ricardoquesada/unipad/firmware/README.md

# Unipad™ Firmware

This directory contains the board-specific **Raspberry Pi Pico 2 W (`RP2350` + `CYW43439`)** firmware, cycle-exact Programmable I/O (`PIO`) hardware state machines, and [Bluepad32](https://github.com/ricardoquesada/bluepad32) platform integration for **Unipad** retro computer adapters.

## Directory Layout

```text
firmware/
├── external/               # Third-party / upstream git submodules (isolated from 1st-party code)
│   └── bluepad32/          # Bluepad32 Bluetooth Classic + BLE HID stack (git submodule)
├── common/                 # Shared RP2350 drivers & hardware contracts across Unipad boards
│   ├── CMakeLists.txt      # unipad_common static library target
│   ├── include/
│   │   └── unipad_board_id.h       # 3-bit BOARD_ID[2:0] = {GP28, GP27, GP26} contract & registry
│   └── src/
│       └── unipad_board_id.c       # Boot-time pull-up sampling, majority vote & post-boot pad isolation
└── unipad_c64/             # Unipad C64 (Rev. A) target — defaults to PICO_BOARD=pico2_w
    ├── CMakeLists.txt      # Pico SDK 2.x + Bluepad32 + hardware_pio + unipad_common build definition
    ├── pico_sdk_import.cmake
    ├── include/
    │   ├── unipad_c64_pins.h       # Exact RP2350 pinout matching hardware/unipad_c64/pico2w.kicad_sch
    │   ├── unipad_c64_gpio.h       # Atomic 5-bit SIO ports, LEDs, autofire & pushbutton debouncer
    │   ├── unipad_c64_pio.h        # PIO SID 1351 mouse, 1311/1312 paddles, POT buttons & Rumble/Sync
    │   ├── unipad_c64_platform.h   # Bluepad32 custom uni_platform & runtime mode/seat control
    │   └── unipad_c64_console.h    # Non-blocking USB CDC & UART0 interactive CLI
    ├── pio/
    │   └── c64_sid_pot.pio         # RP2350 PIO state machines (c64_sid_pot & c64_sid_sync_measure)
    └── src/
        ├── btstack_config.h        # Dual-mode Classic BR/EDR + BLE + Flash TLV configuration
        ├── sdkconfig.h             # Bluepad32 PICO_W + custom platform configuration
        ├── main.c                  # RP2350 boot sequence, Board ID interlock & BTstack event loop
        ├── unipad_c64_gpio.c
        ├── unipad_c64_pio.c
        ├── unipad_c64_platform.c
        └── unipad_c64_console.c
```

## Hardware Board Identification (`unipad_board_id`)

Every Unipad carrier PCB encodes a 3-bit hardware identifier on the three 3.3V-only RP2350 pads **`BOARD_ID[2:0] = {GP28, GP27, GP26}`** (`JP3`, `JP2`, `JP1` copper solder jumpers to `GND`; **`OPEN = 1`**, **`GND = 0`**):

- **Boot-Time Sampling & Zero Static Current**: `unipad_board_id_detect()` enables RP2350 internal pull-ups (`~50..80 kΩ`, avoiding `RP2350-E9` pull-down latching) + Schmitt hysteresis for `~28 µs`, performs a 3-sample majority vote, and immediately disables both pulls and digital input buffers (`IE = 0`) for **`0.0 µA` steady-state current**.
- **Wrong-Board Fail-Safe Interlock**: Before driving any external GPIO or PIO state machine, each board target verifies `unipad_board_id_matches(...)`. On mismatch (e.g., C64 `.uf2` flashed onto a future Amiga/Atari carrier), all external `GP0..GP28` pins remain locked in Hi-Z, USB CDC reports the detected vs. expected board ID, and the Pico 2 W onboard LED (`WL_GPIO0`) blinks a 3-pulse warning code.

## Prerequisites

1. **Raspberry Pi Pico SDK (`>= 2.0.0`, tested with `2.3.1` for RP2350 `pico2_w`)**:
   Set `PICO_SDK_PATH` in your shell environment (e.g., `export PICO_SDK_PATH=~/src/rpi/pico-sdk`).
2. **ARM Embedded Toolchain & CMake**:
   ```bash
   brew install cmake ninja arm-none-eabi-gcc
   ```
3. **Submodules Initialized**:
   ```bash
   git submodule update --init --recursive
   ```

## Building `unipad_c64.uf2`

```bash
cmake -S firmware/unipad_c64 -B firmware/unipad_c64/build
cmake --build firmware/unipad_c64/build -j8
```

> **Note:** `PICO_BOARD` defaults automatically to `pico2_w` (`RP2350` + `CYW43439`). The compiled firmware image is generated at `firmware/unipad_c64/build/unipad_c64.uf2`. Pass `-DUNIPAD_WARNINGS_AS_ERRORS=ON` to match the strict `-Werror` check enforced on first-party Unipad sources in GitHub Actions ([`.github/workflows/build-firmware.yml`](../.github/workflows/build-firmware.yml)).

## Flashing `.uf2` Firmware to Unipad

1. Hold down the **`BOOTSEL`** button on the Pico 2 W while plugging a Micro-USB cable into your computer (ensure the C64 is **powered OFF** or Unipad is unplugged from the C64 unless `D3` Schottky USB isolation is populated, which is standard on Unipad C64 Rev. A).
2. Release `BOOTSEL` — the board mounts as a USB mass-storage volume named **`RP2350`**.
3. Copy `firmware/unipad_c64/build/unipad_c64.uf2` onto the `RP2350` volume; the Pico 2 W reboots automatically into Unipad C64.
