ricardoquesada/unipad/hardware/unipad_c64/gerber_jlcpcb_rev_a/unipad_c64_bom_jlcpcb.csv

Comment | Designator | Footprint | LCSC | MPN | Manufacturer
.1uF | C1,C4,C8,C10,C11,C12,C13 | Capacitor_SMD:C_0805_2012Metric_Pad1.18x1.45mm_HandSolder | C49678 | CC0805KRX7R9BB104 | YAGEO
10uF | C5,C6,C9 | Capacitor_SMD:C_0805_2012Metric_Pad1.18x1.45mm_HandSolder | C15850 | CL21A106KAYNNNE | Samsung Electro-Mechanics
47uF | C7 | Capacitor_SMD:C_0805_2012Metric_Pad1.18x1.45mm_HandSolder | C124129 | GRM21BR61A476ME15L | Murata Electronics
PWR | D1 | LED_SMD:LED_0805_2012Metric_Pad1.15x1.40mm_HandSolder | C2297 | KT-0805G | Hubei KENTO Elec
BLUE | D4 | LED_SMD:LED_0805_2012Metric_Pad1.15x1.40mm_HandSolder | C84259 | NCD0805B2 | Foshan NationStar Optoelectronics
GREEN | D5 | LED_SMD:LED_0805_2012Metric_Pad1.15x1.40mm_HandSolder | C2297 | KT-0805G | Hubei KENTO Elec
RED | D6 | LED_SMD:LED_0805_2012Metric_Pad1.15x1.40mm_HandSolder | C84256 | NCD0805R1 | Foshan NationStar Optoelectronics
250mA_PTC | F1 | Fuse:Fuse_0805_2012Metric | C20608679 | 0805L025/36XR | LUTE
600R@100MHz | FB1 | Inductor_SMD:L_0805_2012Metric | C1017 | GZ2012D601TF | Sunlord
DMG2305UX | Q1 | Package_TO_SOT_SMD:SOT-23 | C144153 | DMG2305UX-13 | Diodes Incorporated
10K | R1,R10,R11,R13,R14,R16,R17,R19,R22 | Resistor_SMD:R_0805_2012Metric_Pad1.20x1.40mm_HandSolder | C17414 | 0805W8F1002T5E | UNI-ROYAL
3K3 | R2,R7,R8,R9 | Resistor_SMD:R_0805_2012Metric_Pad1.20x1.40mm_HandSolder | C26010 | 0805W8F3301T5E | UNI-ROYAL
100K | R3 | Resistor_SMD:R_0805_2012Metric_Pad1.20x1.40mm_HandSolder | C149504 | 0805W8F1003T5E | UNI-ROYAL
22K | R20,R23 | Resistor_SMD:R_0805_2012Metric_Pad1.20x1.40mm_HandSolder | C17560 | 0805W8F2202T5E | UNI-ROYAL
74HCT05 | U4,U5,U6 | Package_SO:SOIC-14_3.9x8.7mm_P1.27mm | C49188197 | EM74HCT05D | EnergyMath
