ricardoquesada/unipad/case/unipad_c64/unipad_c64_case_assembly.step

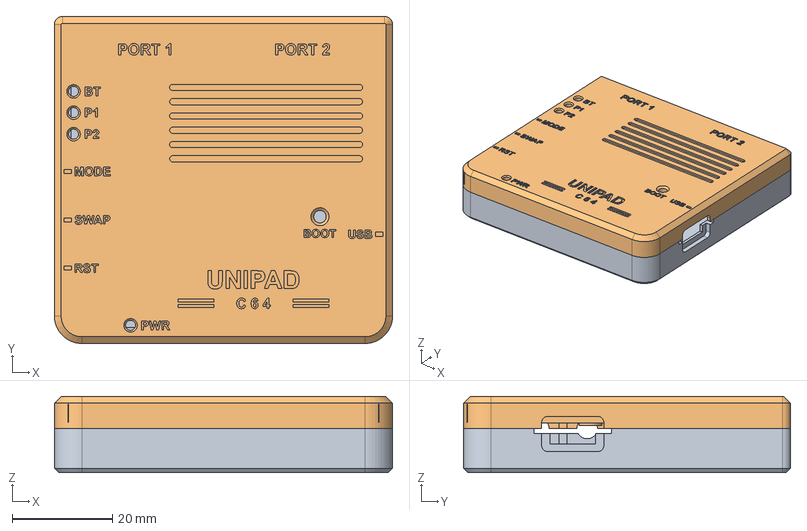
[picture p1: CAD file, 2026-10-27]
case/unipad_c64/unipad_c64_case_assembly.step
67.5 x 65.3 x 15.2 mm
Unipad_C64_Bottom_Tray
Unipad_C64_Top_Lid
