ricardoquesada/unipad/case/unipad_c64/unipad_c64_print_plate.3mf

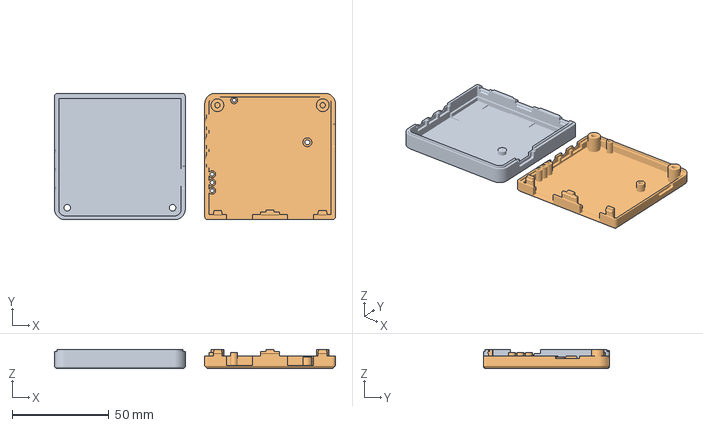
[picture p2: CAD file, 2026-10-27]
case/unipad_c64/unipad_c64_print_plate.3mf
145.0 x 65.2 x 9.84 mm
