ricardoquesada/unipad/case/unipad_c64/unipad_c64_top.step

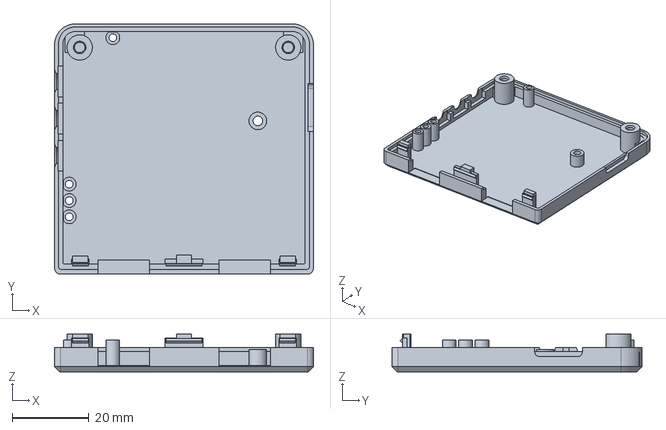
[picture p3: CAD file, 2026-10-27]
case/unipad_c64/unipad_c64_top.step
67.5 x 65.3 x 9.84 mm
