ricardoquesada/unipad/(list of files, cad)

Other CAD files:
case/unipad_c64/unipad_c64_bottom.step
case/unipad_c64/unipad_c64_bottom.3mf
case/unipad_c64/unipad_c64_bottom.stl
case/unipad_c64/unipad_c64_print_plate.stl
case/unipad_c64/unipad_c64_top.3mf
case/unipad_c64/unipad_c64_top.stl
