ricardoquesada/unipad/docs/schematics/schematic_unipad_c64.pdf

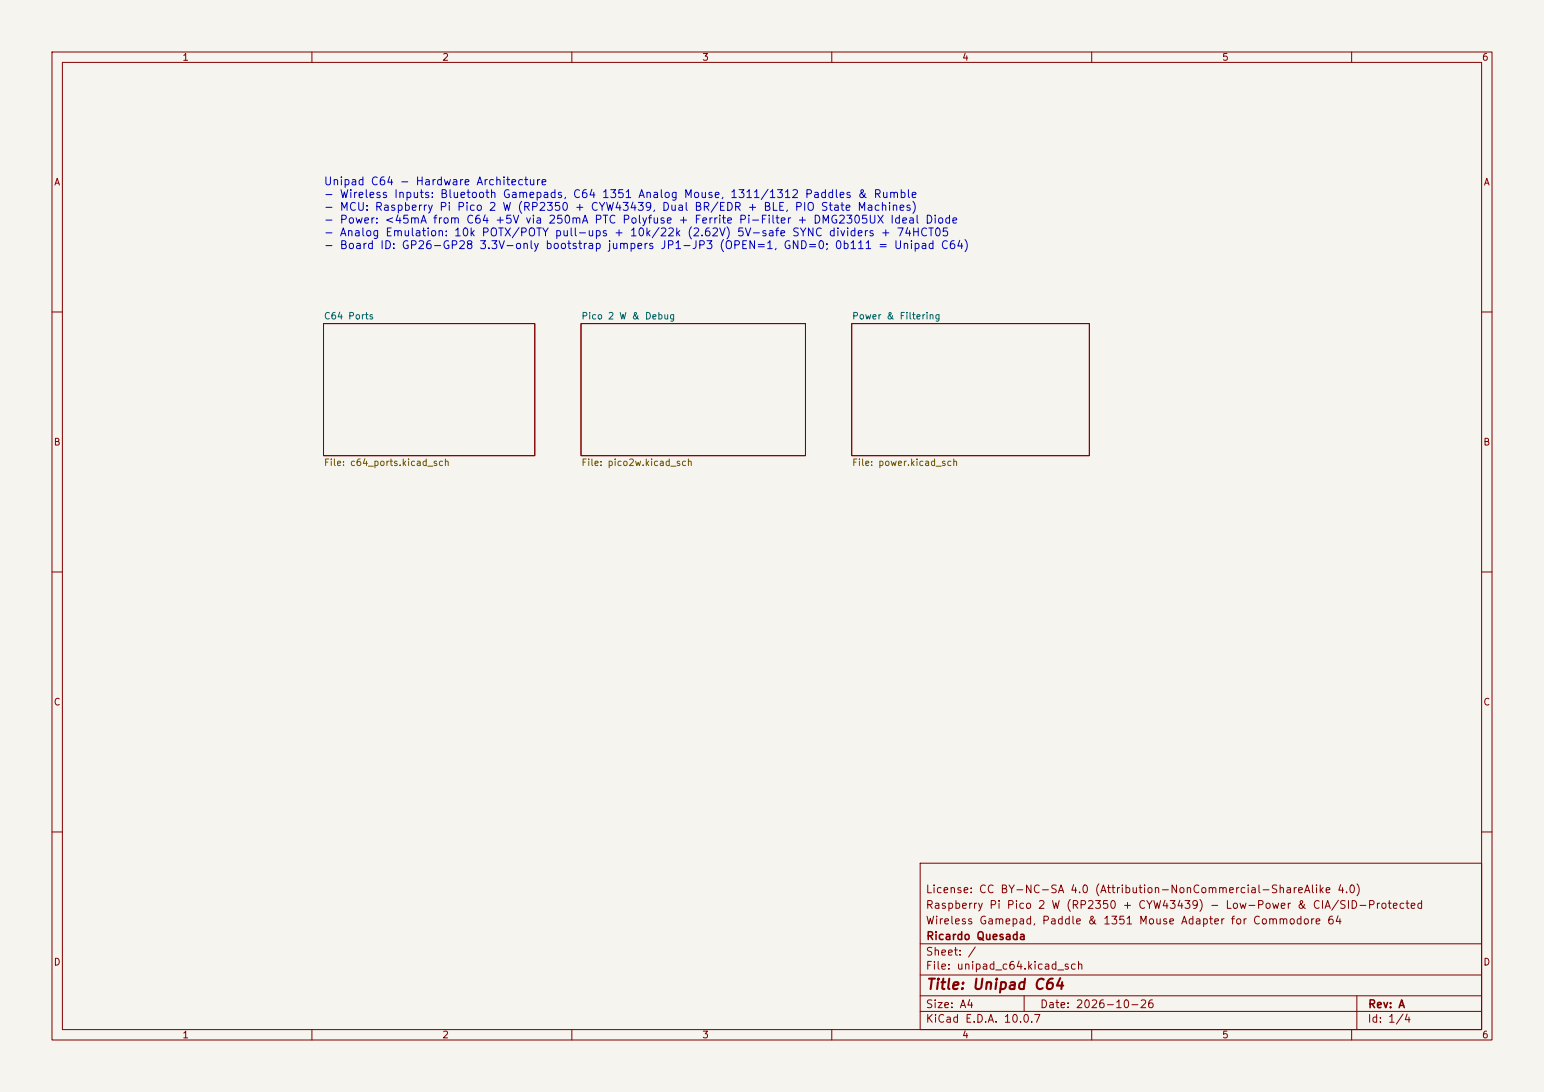
[picture p4: page 1]

Unipad C64 - Hardware Architecture - Wireless Inputs: Bluetooth Gamepads, C64 1351 Analog Mouse, 1311/1312 Paddles & Rumble - MCU: Raspberry Pi Pico 2 W (RP2350 + CYW43439, Dual BR/EDR + BLE, PIO State Machines) - Power: <45mA from C64 +5V via 250mA PTC Polyfuse + Ferrite Pi-Filter + DMG2305UX Ideal Diode - Analog Emulation: 10k POTX/POTY pull-ups + 10k/22k (2.62V) 5V-safe SYNC dividers + 74HCT05 - Board ID: GP26-GP28 3.3V-only bootstrap jumpers JP1-JP3 (OPEN=1, GND=0; 0b111 = Unipad C64)

License: CC BY-NC-SA 4.0 (Attribution-NonCommercial-ShareAlike 4.0)
Raspberry Pi Pico 2 W (RP2350 + CYW43439) - Low-Power & CIA/SID-Protected
Wireless Gamepad, Paddle & 1351 Mouse Adapter for Commodore 64
Ricardo Quesada
Sheet: /
File: unipad_c64.kicad_sch
Title: Unipad C64

Size: A4 | Rev: A
KiCad E.D.A. 10.0.7 | Id: 1/4

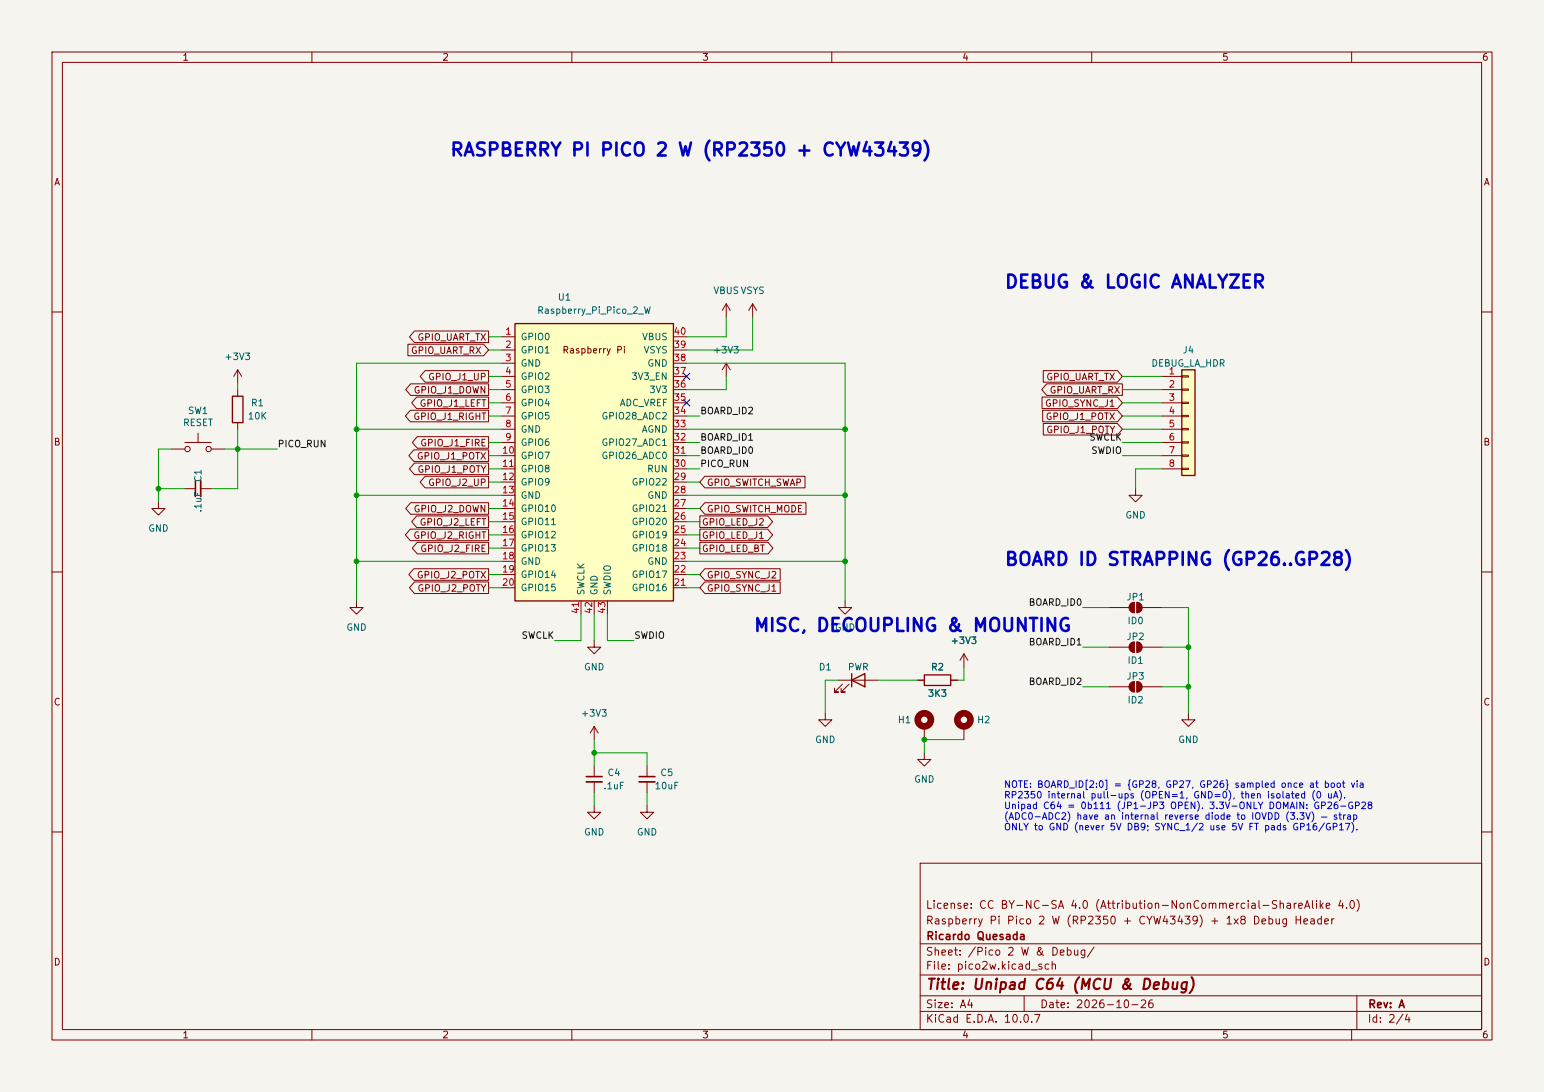
[picture p5: page 2]

NOTE: BOARD_ID[2:0] = {GP28, GP27, GP26} sampled once at boot via RP2350 internal pull-ups (OPEN=1, GND=0), then isolated (0 uA).

Unipad C64 = 0b111 (JP1-JP3 OPEN). 3.3V-ONLY DOMAIN: GP26-GP28
(ADC0-ADC2) have an internal reverse diode to IOVDD (3.3V) — strap ONLY to GND (never 5V DB9; SYNC_1/2 use 5V FT pads GP16/GP17).

Raspberry Pi Pico 2 W (RP2350 + CYW43439) + 1x8 Debug Header
Ricardo Quesada
Sheet: /Pico 2 W & Debug/
File: pico2w.kicad_sch
Title: Unipad C64 (MCU & Debug)

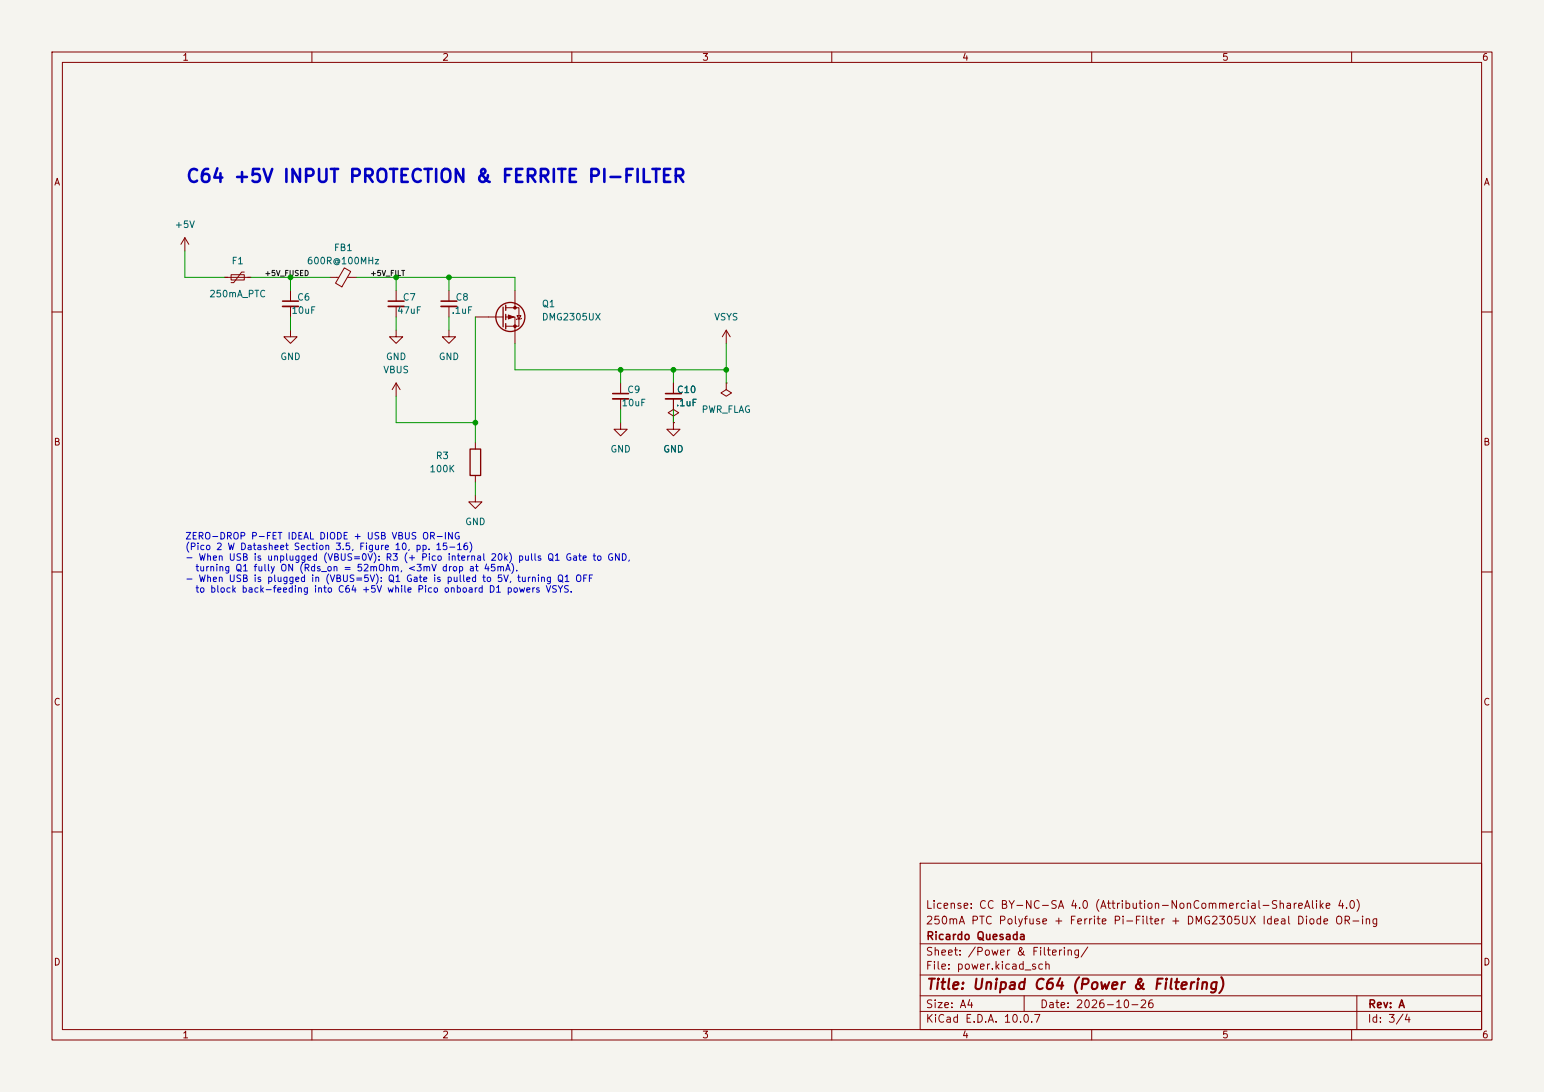
[picture p6: page 3]

ZERO-DROP P-FET IDEAL DIODE + USB VBUS OR-ING
(Pico 2 W Datasheet Section 3.5, Figure 10, pp. 15-16) - When USB is unplugged (VBUS=0V): R3 (+ Pico internal 20k) pulls Q1 Gate to GND,

turning Q1 fully ON (Rds_on = 52mOhm, <3mV drop at 45mA). - When USB is plugged in (VBUS=5V): Q1 Gate is pulled to 5V, turning Q1 OFF

License: CC BY-NC-SA 4.0 (Attribution-NonCommercial-ShareAlike 4.0)
250mA PTC Polyfuse + Ferrite Pi-Filter + DMG2305UX Ideal Diode OR-ing
Ricardo Quesada
Sheet: /Power & Filtering/
File: power.kicad_sch
Title: Unipad C64 (Power & Filtering)

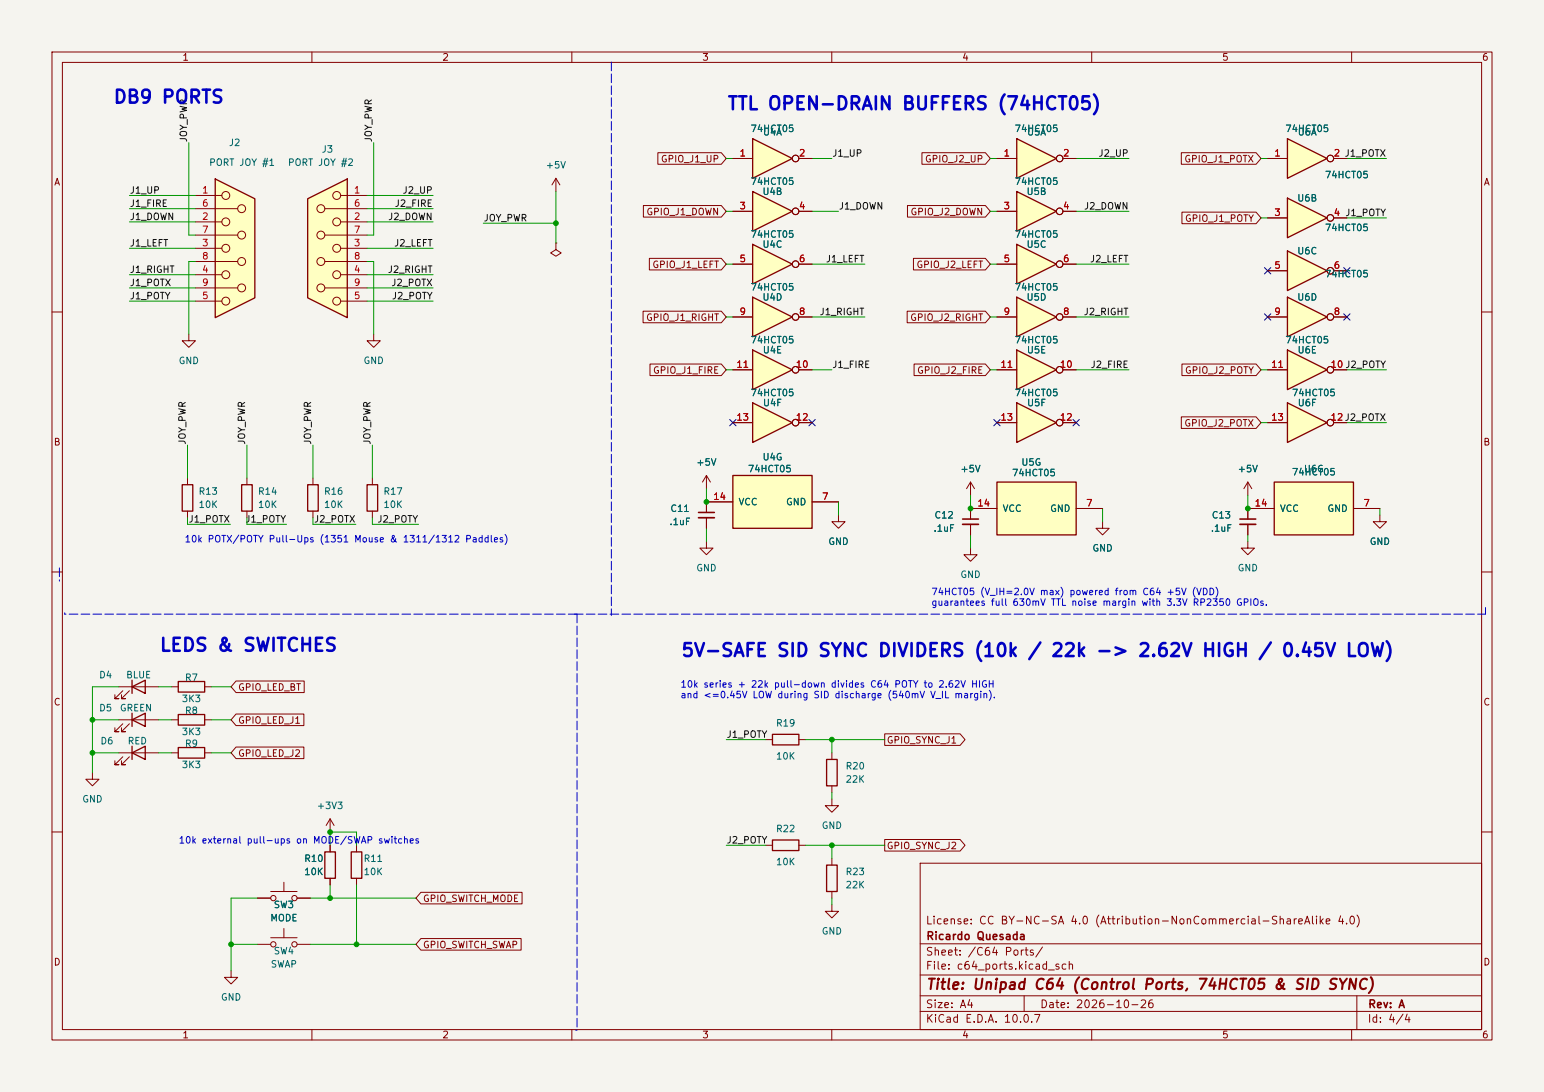
[picture p7: page 4]

and <=0.45V LOW during SID discharge (540mV V_IL margin). 10k external pull-ups on MODE/SWAP switches DB9 PORTS

TTL OPEN-DRAIN BUFFERS (74HCT05)

guarantees full 630mV TTL noise margin with 3.3V RP2350 GPIOs. 10k POTX/POTY Pull-Ups (1351 Mouse & 1311/1312 Paddles)

74HCT05 (V_IH=2.0V max) powered from C64 +5V (VDD)

5V-SAFE SID SYNC DIVIDERS (10k / 22k -> 2.62V HIGH / 0.45V LOW)

License: CC BY-NC-SA 4.0 (Attribution-NonCommercial-ShareAlike 4.0)
Ricardo Quesada
Sheet: /C64 Ports/
File: c64_ports.kicad_sch
Title: Unipad C64 (Control Ports, 74HCT05 & SID SYNC)
