ricardoquesada/unipad/hardware/unipad_c64/unipad_c64.kicad_pcb

## KiCad design hardware/unipad_c64/unipad_c64.kicad_pcb (2026-10-27)

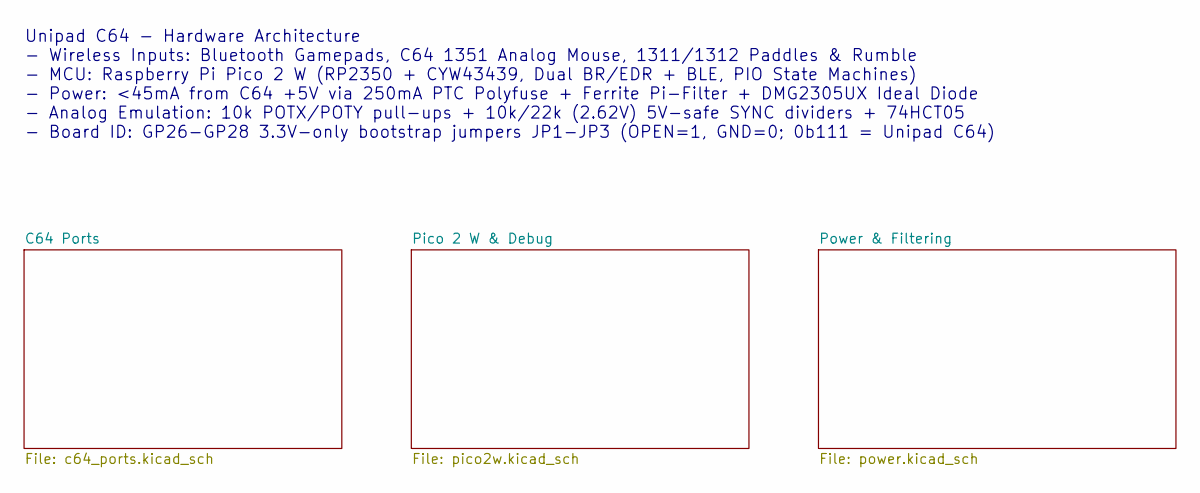
[picture p8: schematic unipad_c64.kicad_sch, Unipad C64]

Notes on the sheet:
Unipad C64 - Hardware Architecture - Wireless Inputs: Bluetooth Gamepads, C64 1351 Analog Mouse, 1311/1312 Paddles & Rumble - MCU: Raspberry Pi Pico 2 W (RP2350 + CYW43439, Dual BR/EDR + BLE, PIO State Machines) - Power: <45mA from C64 +5V via 250mA PTC Polyfuse + Ferrite Pi-Filter + DMG2305UX Idea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

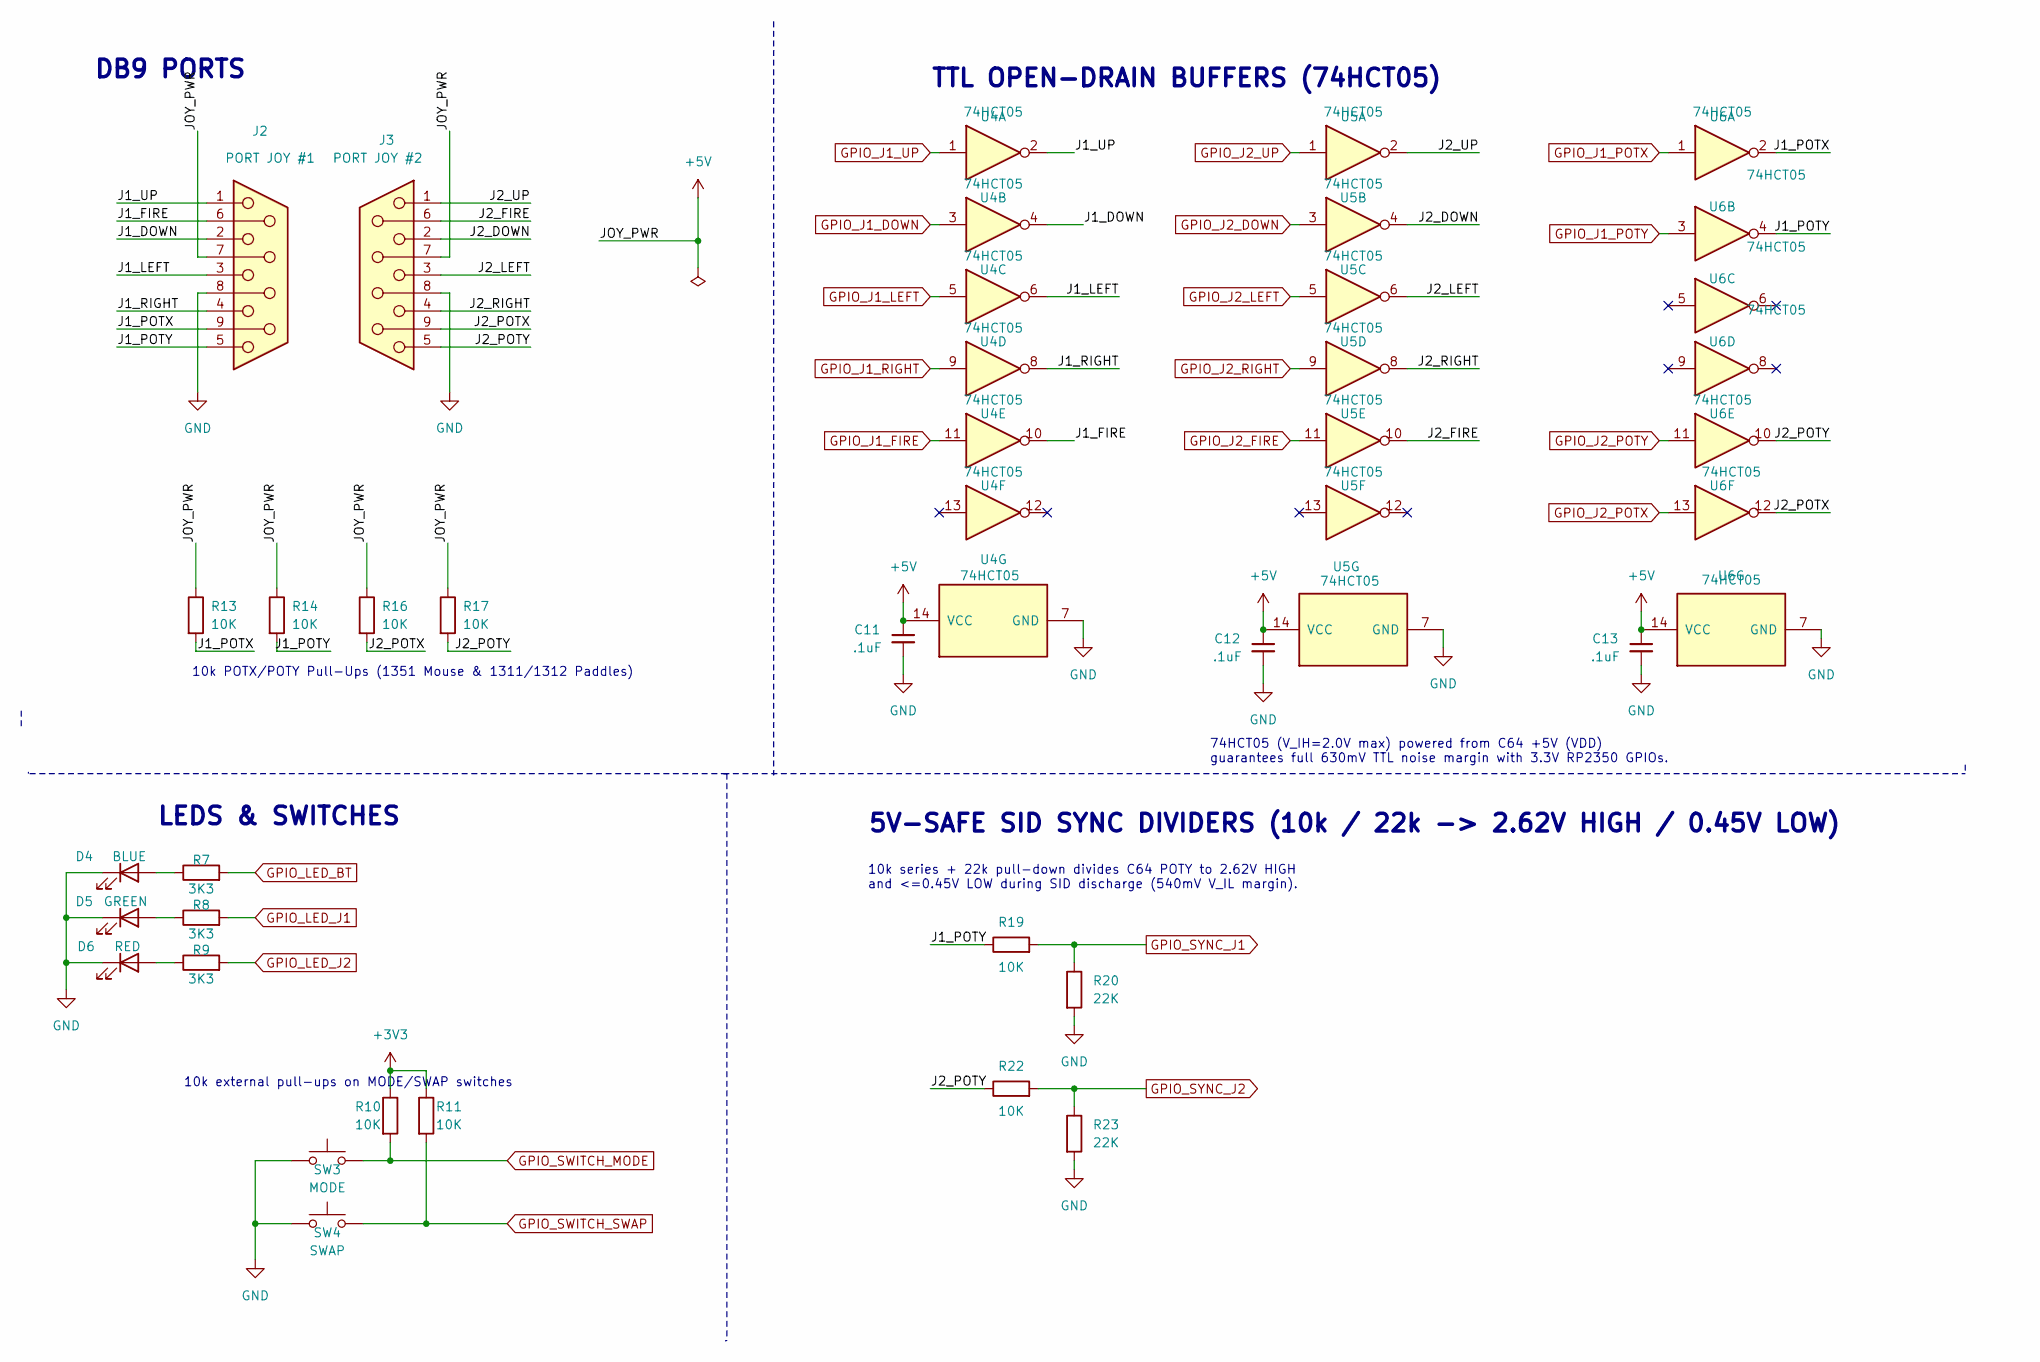
[picture p9: schematic c64_ports.kicad_sch, Unipad C64 (Control Ports, 74HCT05 & SID SYNC)]

Parts:
C11, C12, C13: .1uF; C_0805_2012Metric_Pad1.18x1.45mm_HandSolder; MPN CC0805KRX7R9BB104; LCSC C49678
D4: BLUE; LED_0805_2012Metric_Pad1.15x1.40mm_HandSolder; MPN NCD0805B2; LCSC C84259
D5: GREEN; LED_0805_2012Metric_Pad1.15x1.40mm_HandSolder; MPN KT-0805G; LCSC C2297
D6: RED; LED_0805_2012Metric_Pad1.15x1.40mm_HandSolder; MPN NCD0805R1; LCSC C84256
J2: PORT JOY #1; DSUB-9_Socket_Horizontal_P2.77x2.54mm_EdgePinOffset9.40mm
J3: PORT JOY #2; DSUB-9_Socket_Horizontal_P2.77x2.54mm_EdgePinOffset9.40mm
R7, R8, R9: 3K3; R_0805_2012Metric_Pad1.20x1.40mm_HandSolder; MPN 0805W8F3301T5E; LCSC C26010
R10, R11, R13, R14, R16, R17, R19, R22: 10K; R_0805_2012Metric_Pad1.20x1.40mm_HandSolder; MPN 0805W8F1002T5E; LCSC C17414
R20, R23: 22K; R_0805_2012Metric_Pad1.20x1.40mm_HandSolder; MPN 0805W8F2202T5E; LCSC C17560
SW3: MODE; SW_Tactile_SPST_Angled_PTS645Vx39-2LFS; MPN PTS645VH39-2 LFS
SW4: SWAP; SW_Tactile_SPST_Angled_PTS645Vx39-2LFS; MPN PTS645VH39-2 LFS
U4, U5, U6: 74HCT05; SOIC-14_3.9x8.7mm_P1.27mm; MPN EM74HCT05D; LCSC C49188197

Connections:
+3V3: R10.1, R11.1; also elsewhere on the board
+5V: C11.1, C12.1, C13.1, J2.7, J3.7, R13.1, R14.1, R16.1, R17.1, U4.14 (VCC), U5.14 (VCC), U6.14 (VCC); also elsewhere on the board
/C64 Ports/J1_DOWN: J2.2, U4.4
/C64 Ports/J1_FIRE: J2.6, U4.10
/C64 Ports/J1_LEFT: J2.3, U4.6
/C64 Ports/J1_POTX: J2.9, R13.2, U6.2
/C64 Ports/J1_POTY: J2.5, R14.2, R19.1, U6.4
/C64 Ports/J1_RIGHT: J2.4, U4.8
/C64 Ports/J1_UP: J2.1, U4.2
/C64 Ports/J2_DOWN: J3.2, U5.4
/C64 Ports/J2_FIRE: J3.6, U5.10
/C64 Ports/J2_LEFT: J3.3, U5.6
/C64 Ports/J2_POTX: J3.9, R16.2, U6.12
/C64 Ports/J2_POTY: J3.5, R17.2, R22.1, U6.10
/C64 Ports/J2_RIGHT: J3.4, U5.8
/C64 Ports/J2_UP: J3.1, U5.2
GND: C11.2, C12.2, C13.2, D4.1 (K), D5.1 (K), D6.1 (K), J2.8, J3.8, R20.2, R23.2, SW3.1, SW4.1, U4.7 (GND), U5.7 (GND), U6.7 (GND); also elsewhere on the board
GPIO_J1_DOWN: U4.3; also elsewhere on the board
GPIO_J1_FIRE: U4.11; also elsewhere on the board
GPIO_J1_LEFT: U4.5; also elsewhere on the board
GPIO_J1_POTX: U6.1; also elsewhere on the board
GPIO_J1_POTY: U6.3; also elsewhere on the board
GPIO_J1_RIGHT: U4.9; also elsewhere on the board
GPIO_J1_UP: U4.1; also elsewhere on the board
GPIO_J2_DOWN: U5.3; also elsewhere on the board
GPIO_J2_FIRE: U5.11; also elsewhere on the board
GPIO_J2_LEFT: U5.5; also elsewhere on the board
GPIO_J2_POTX: U6.13; also elsewhere on the board
GPIO_J2_POTY: U6.11; also elsewhere on the board
GPIO_J2_RIGHT: U5.9; also elsewhere on the board
GPIO_J2_UP: U5.1; also elsewhere on the board
GPIO_LED_BT: R7.2; also elsewhere on the board
GPIO_LED_J1: R8.2; also elsewhere on the board
GPIO_LED_J2: R9.2; also elsewhere on the board
GPIO_SWITCH_MODE: R10.2, SW3.2; also elsewhere on the board
GPIO_SWITCH_SWAP: R11.2, SW4.2; also elsewhere on the board
GPIO_SYNC_J1: R19.2, R20.1; also elsewhere on the board
GPIO_SYNC_J2: R22.2, R23.1; also elsewhere on the board
unnamed: D4.2 (A), R7.1
unnamed: D5.2 (A), R8.1
unnamed: D6.2 (A), R9.1

Notes on the sheet:
LEDS & SWITCHES
10k external pull-ups on MODE/SWAP switches
74HCT05 (V_IH=2.0V max) powered from C64 +5V (VDD) guarantees full 630mV TTL noise margin with 3.3V RP2350 GPIOs.
5V-SAFE SID SYNC DIVIDERS (10k / 22k -> 2.62V HIGH / 0.45V LOW)
DB9 PORTS
TTL OPEN-DRAIN BUFFERS (74HCT05)
10k series + 22k pull-down divides C64 POTY to 2.62V HIGH and <=0.45V LOW during SID discharge (540mV V_IL margin).
10k POTX/POTY Pull-Ups (1351 Mouse & 1311/1312 Paddles)

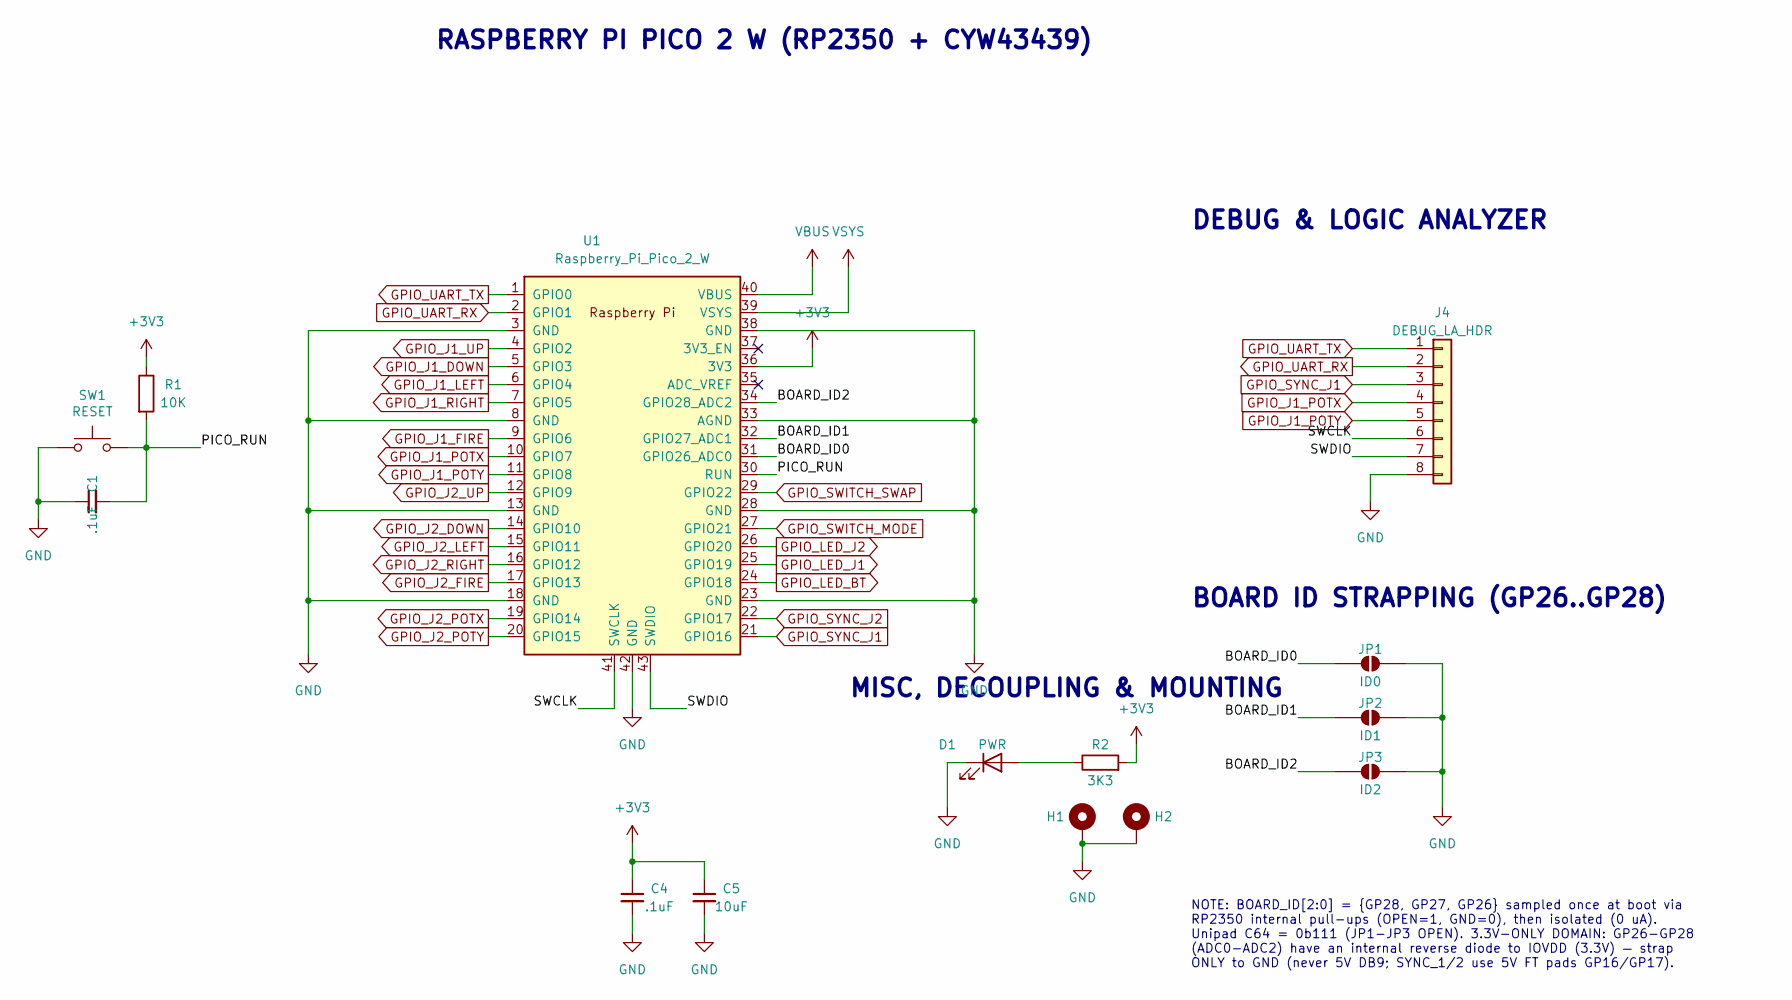
[picture p10: schematic pico2w.kicad_sch, Unipad C64 (MCU & Debug)]

Parts:
C1, C4: .1uF; C_0805_2012Metric_Pad1.18x1.45mm_HandSolder; MPN CC0805KRX7R9BB104; LCSC C49678
C5: 10uF; C_0805_2012Metric_Pad1.18x1.45mm_HandSolder; MPN CL21A106KAYNNNE; LCSC C15850
D1: PWR; LED_0805_2012Metric_Pad1.15x1.40mm_HandSolder; MPN KT-0805G; LCSC C2297
H1, H2: MountingHole_Pad; MountingHole_3.2mm_M3_Pad_Via
J4: DEBUG_LA_HDR; PinHeader_1x08_P2.54mm_Vertical
JP1: ID0; SolderJumper-2_P1.3mm_Open_RoundedPad1.0x1.5mm
JP2: ID1; SolderJumper-2_P1.3mm_Open_RoundedPad1.0x1.5mm
JP3: ID2; SolderJumper-2_P1.3mm_Open_RoundedPad1.0x1.5mm
R1: 10K; R_0805_2012Metric_Pad1.20x1.40mm_HandSolder; MPN 0805W8F1002T5E; LCSC C17414
R2: 3K3; R_0805_2012Metric_Pad1.20x1.40mm_HandSolder; MPN 0805W8F3301T5E; LCSC C26010
SW1: RESET; SW_Tactile_SPST_Angled_PTS645Vx39-2LFS; MPN PTS645VH39-2 LFS
U1: Raspberry_Pi_Pico_2_W; RPi_Pico_2_W_SMD_TH; MPN SC1633

Connections:
+3V3: C4.1, C5.1, R1.1, R2.2, U1.36 (3V3); also elsewhere on the board
/Pico 2 W & Debug/BOARD_ID0: JP1.1 (A), U1.31 (GPIO26_ADC0)
/Pico 2 W & Debug/BOARD_ID1: JP2.1 (A), U1.32 (GPIO27_ADC1)
/Pico 2 W & Debug/BOARD_ID2: JP3.1 (A), U1.34 (GPIO28_ADC2)
/Pico 2 W & Debug/PICO_RUN: C1.2, R1.2, SW1.2, U1.30 (RUN)
/Pico 2 W & Debug/SWCLK: J4.6, U1.41 (SWCLK)
/Pico 2 W & Debug/SWDIO: J4.7, U1.43 (SWDIO)
GND: C1.1, C4.2, C5.2, D1.1 (K), H1.1, H2.1, J4.8, JP1.2 (B), JP2.2 (B), JP3.2 (B), SW1.1, U1.3 (GND), U1.8 (GND), U1.13 (GND), U1.18 (GND), U1.23 (GND), U1.28 (GND), U1.33 (AGND), U1.38 (GND), U1.42 (GND); also elsewhere on the board
GPIO_J1_DOWN: U1.5 (GPIO3); also elsewhere on the board
GPIO_J1_FIRE: U1.9 (GPIO6); also elsewhere on the board
GPIO_J1_LEFT: U1.6 (GPIO4); also elsewhere on the board
GPIO_J1_POTX: J4.4, U1.10 (GPIO7); also elsewhere on the board
GPIO_J1_POTY: J4.5, U1.11 (GPIO8); also elsewhere on the board
GPIO_J1_RIGHT: U1.7 (GPIO5); also elsewhere on the board
GPIO_J1_UP: U1.4 (GPIO2); also elsewhere on the board
GPIO_J2_DOWN: U1.14 (GPIO10); also elsewhere on the board
GPIO_J2_FIRE: U1.17 (GPIO13); also elsewhere on the board
GPIO_J2_LEFT: U1.15 (GPIO11); also elsewhere on the board
GPIO_J2_POTX: U1.19 (GPIO14); also elsewhere on the board
GPIO_J2_POTY: U1.20 (GPIO15); also elsewhere on the board
GPIO_J2_RIGHT: U1.16 (GPIO12); also elsewhere on the board
GPIO_J2_UP: U1.12 (GPIO9); also elsewhere on the board
GPIO_LED_BT: U1.24 (GPIO18); also elsewhere on the board
GPIO_LED_J1: U1.25 (GPIO19); also elsewhere on the board
GPIO_LED_J2: U1.26 (GPIO20); also elsewhere on the board
GPIO_SWITCH_MODE: U1.27 (GPIO21); also elsewhere on the board
GPIO_SWITCH_SWAP: U1.29 (GPIO22); also elsewhere on the board
GPIO_SYNC_J1: J4.3, U1.21 (GPIO16); also elsewhere on the board
GPIO_SYNC_J2: U1.22 (GPIO17); also elsewhere on the board
GPIO_UART_RX: J4.2, U1.2 (GPIO1)
GPIO_UART_TX: J4.1, U1.1 (GPIO0)
unnamed: D1.2 (A), R2.1
VBUS: U1.40 (VBUS); also elsewhere on the board
VSYS: U1.39 (VSYS); also elsewhere on the board

Notes on the sheet:
RASPBERRY PI PICO 2 W (RP2350 + CYW43439)
DEBUG & LOGIC ANALYZER
BOARD ID STRAPPING (GP26..GP28)
NOTE: BOARD_ID[2:0] = {GP28, GP27, GP26} sampled once at boot via RP2350 internal pull-ups (OPEN=1, GND=0), then isolated (0 uA). Unipad C64 = 0b111 (JP1-JP3 OPEN). 3.3V-ONLY DOMAIN: GP26-GP28 (ADC0-ADC2) have an internal reverse diode to IOVDD (3.3V) — strap ONLY to GND (never 5V DB9; SYNC_1/2 use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
MISC, DECOUPLING & MOUNTING

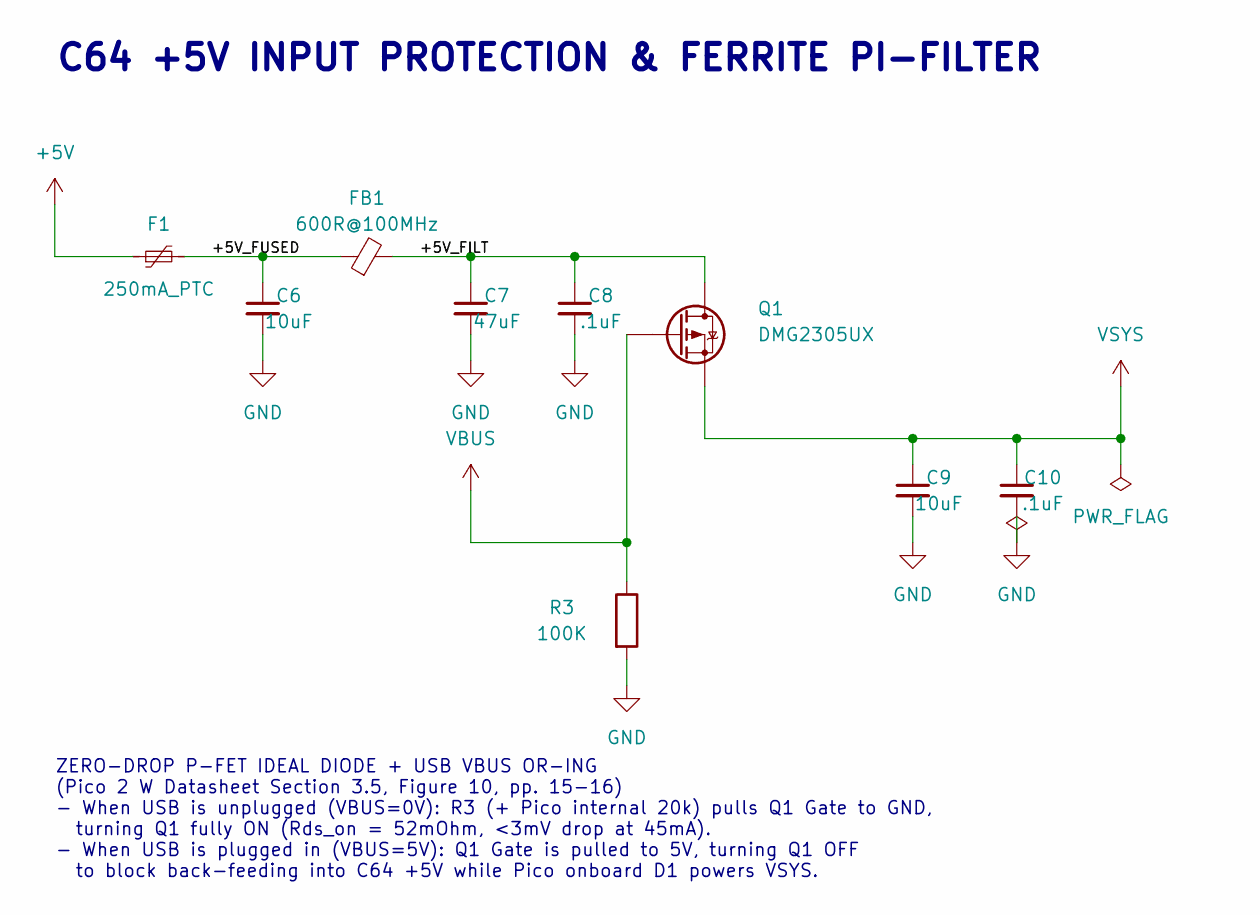
[picture p11: schematic power.kicad_sch, Unipad C64 (Power & Filtering)]

Parts:
C6, C9: 10uF; C_0805_2012Metric_Pad1.18x1.45mm_HandSolder; MPN CL21A106KAYNNNE; LCSC C15850
C7: 47uF; C_0805_2012Metric_Pad1.18x1.45mm_HandSolder; MPN GRM21BR61A476ME15L; LCSC C124129
C8, C10: .1uF; C_0805_2012Metric_Pad1.18x1.45mm_HandSolder; MPN CC0805KRX7R9BB104; LCSC C49678
F1: 250mA_PTC; Fuse_0805_2012Metric; MPN 0805L025/36XR; LCSC C20608679
FB1: 600R@100MHz; L_0805_2012Metric; MPN GZ2012D601TF; LCSC C1017
Q1: DMG2305UX; SOT-23; MPN DMG2305UX-13; LCSC C144153
R3: 100K; R_0805_2012Metric_Pad1.20x1.40mm_HandSolder; MPN 0805W8F1003T5E; LCSC C149504

Connections:
+5V: F1.1; also elsewhere on the board
/Power & Filtering/+5V_FILT: C7.1, C8.1, FB1.2, Q1.3 (D)
/Power & Filtering/+5V_FUSED: C6.1, F1.2, FB1.1
GND: C6.2, C7.2, C8.2, C9.2, C10.2, R3.2; also elsewhere on the board
VBUS: Q1.1 (G), R3.1; also elsewhere on the board
VSYS: C9.1, C10.1, Q1.2 (S); also elsewhere on the board

Notes on the sheet:
C64 +5V INPUT PROTECTION & FERRITE PI-FILTER
ZERO-DROP P-FET IDEAL DIODE + USB VBUS OR-ING (Pico 2 W Datasheet Section 3.5, Figure 10, pp. 15-16) - When USB is unplugged (VBUS=0V): R3 (+ Pico internal 20k) pulls Q1 Gate to GND, turning Q1 fully ON (Rds_on = 52mOhm, <3mV drop at 45mA). - When USB is plugged in (VBUS=5V): Q1 Gate is pulled to 5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

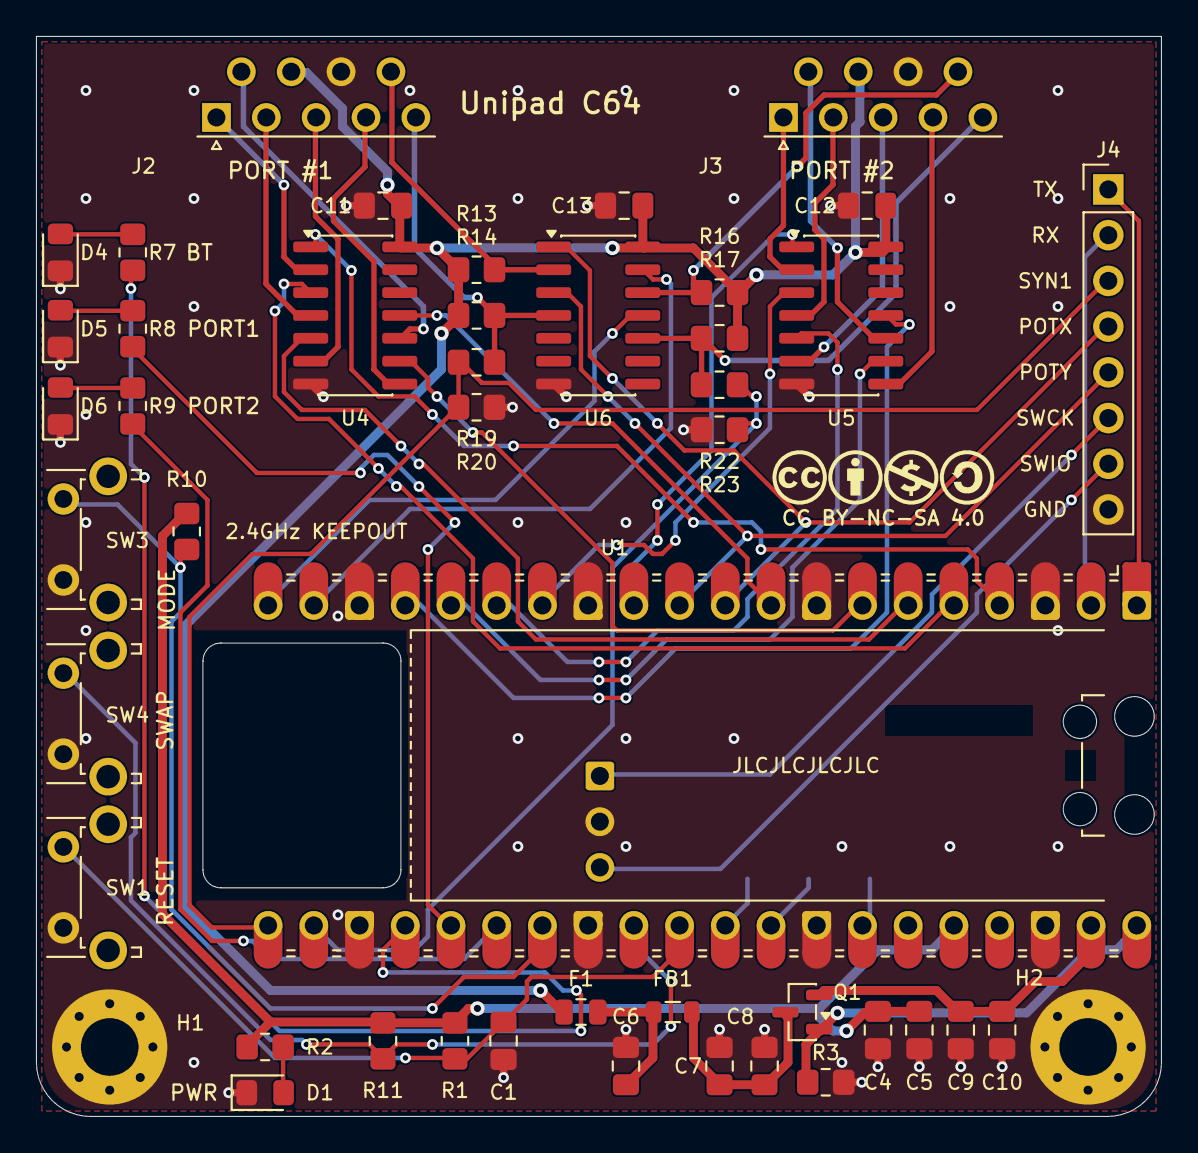
[picture p12: board unipad_c64.kicad_pcb from above]

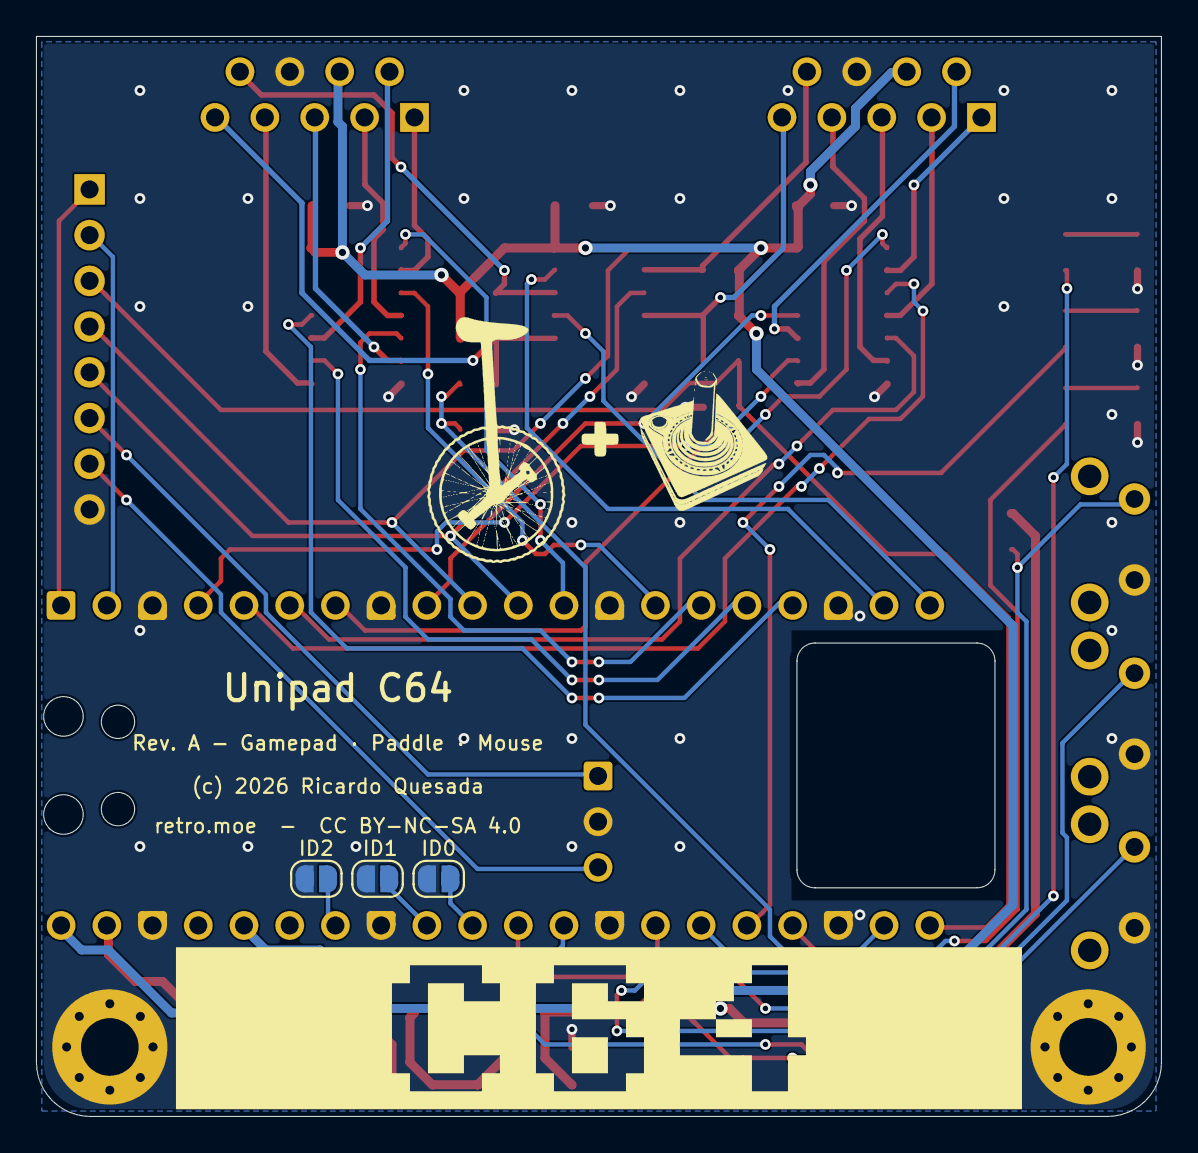
[picture p13: board unipad_c64.kicad_pcb from below]

Board: 4 copper layers, 62.5 x 60.0 mm, 51 parts (4 on the bottom side), 54 nets.

Other parts of the board:
LOGO1: CC_BY-NC-SA_4.0; CC_BY_NC_SA_4_0_SilkScreen
LOGO2: LOGO; unijoysticle_logo_small
