ricardoquesada/unipad/(commit log)

2026-10-27 unipad board
    [c64_ports.kicad_sch, pico2w.kicad_sch, power.kicad_sch, unipad_c64.kicad_pcb, unipad_c64.kicad_sch, unipad_c64_bom_jlcpcb.csv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]
2026-10-27 board id
    [pico2w.kicad_sch, unipad_c64.kicad_pcb, unipad_c64.kicad_sch]
2026-10-27 unipad c64 case
    [unipad_c64_bottom.3mf, unipad_c64_bottom.step, unipad_c64_bottom.stl, unipad_c64_case_assembly.step, unipad_c64_print_plate.3mf, unipad_c64_print_plate.stl, unipad_c64_top.3mf, unipad_c64_top.step]
2026-10-27 unipad 64 silkscreen
    [unipad_c64.kicad_pcb]
