ricardoquesada/unipad/(notices)

Notices in the files:
hardware/unipad_c64/unipad_c64.kicad_pcb:
retro.moe - CC BY-NC-SA 4.0
parts and their libraries:
Creative Commons Attribution-NonCommercial-ShareAlike 4.0 International (CC BY-NC-SA 4.0) Silkscreen Badge
https://creativecommons.org/licenses/by-nc-sa/4.0
